Lucafaessler/FingerprintLockProject/docs/presentation/Final Fingerprint Lock with LCD Display.pptx

## Fingerprint Lock with LCD Display Computer Architecture University of Basel, Fall 2024

Luca Fässler, Barththan Sivanantham, Valerio Job

## Project Goal

Ambition
To build a secure access system that uses biometric authentication with a fingerprint sensor, controlled by an Arduino, to ensure a secure lock
- Secure Access: Biometric system using fingerprint recognition to control entry
- Real-Time Feedback: LCD display shows status (e.g., "Access Granted" or "Access Denied")
- Modular Design: Easily adaptable for various access control applications

University of Basel

## Project Goal

Ambition
To build a secure access system that uses biometric authentication with a fingerprint sensor, controlled by an Arduino, to ensure a secure lock
- Secure Access: Biometric system using fingerprint recognition to control entry
- Real-Time Feedback: LCD display shows status (e.g., "Access Granted" or "Access Denied")
- Time-Based Access: Feature to restrict or allow access based on specific time intervals, enhancing security and operational flexibility
- Modular Design: Easily adaptable for various access control applications

## System Overview

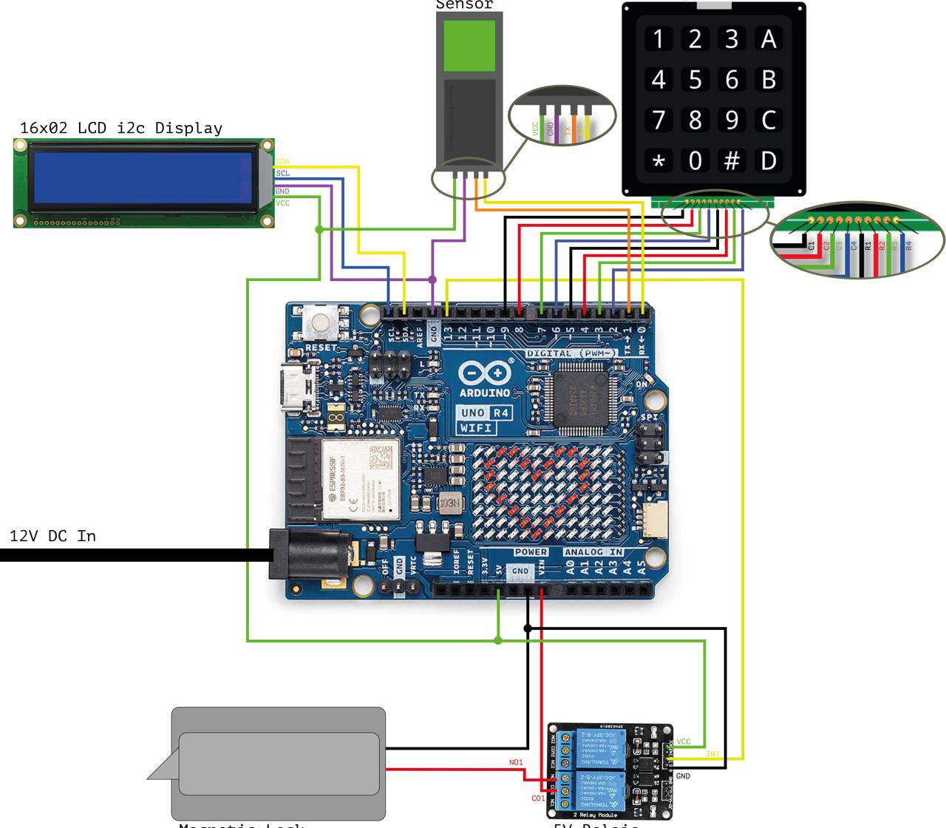
[picture p4: figure]

Circuit Diagram

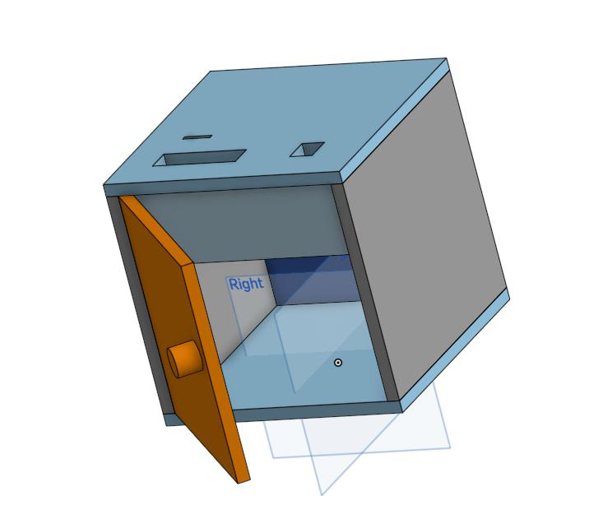
[picture p5: figure]

CAD Visualization

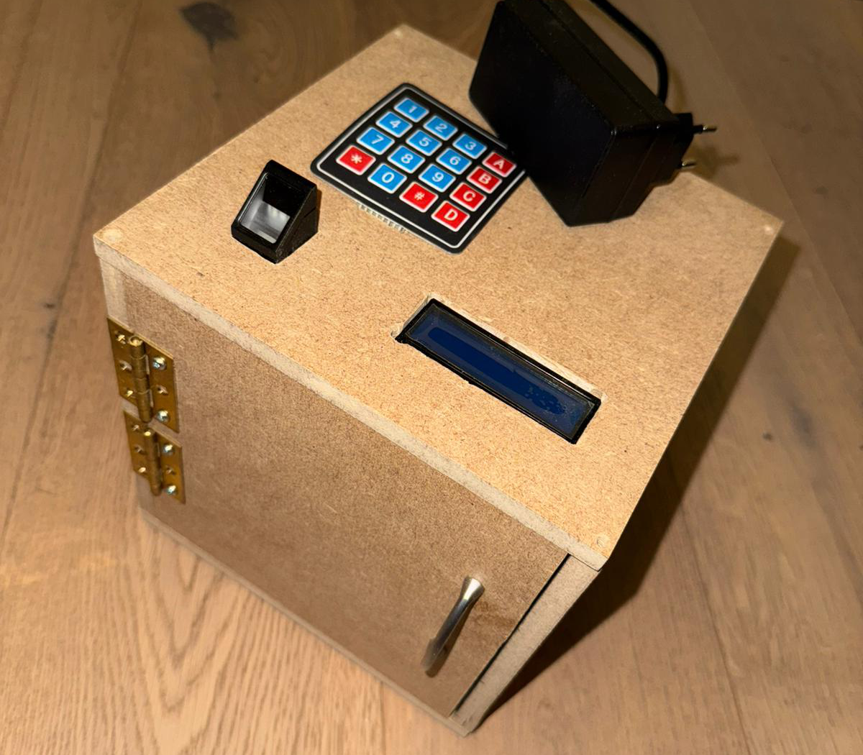
[picture p6: figure]

Final Result

## Hardware Implementation

Hardware
- Arduino UNO R4 Minima/WIFI
- R307 Fingerprint Reader
- 16x2 I2C LCD Display
- 12V DC Electromagnetic Lock
- 2-Channel Relay Module
- 12V DC Power Supply
- Jumper Wires & Breadboard
- RTC SD3031
- Keypad 4x4 Matrix
- Wood, Hinge, Door Handle
Total HW Costs: 236.66 CHF (initially Planned: 106 CHF)

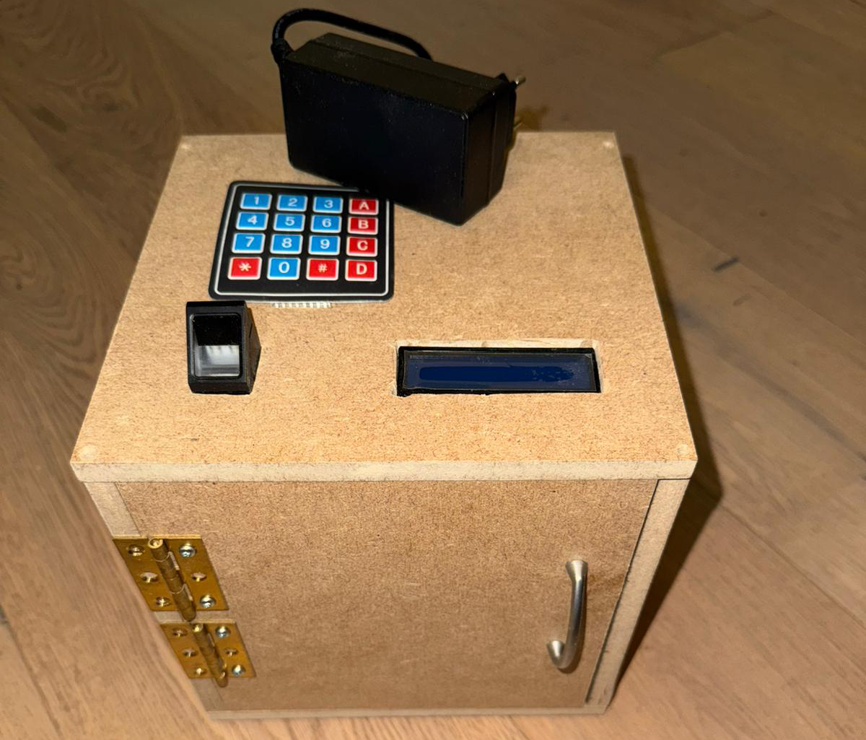
[picture p7: figure]
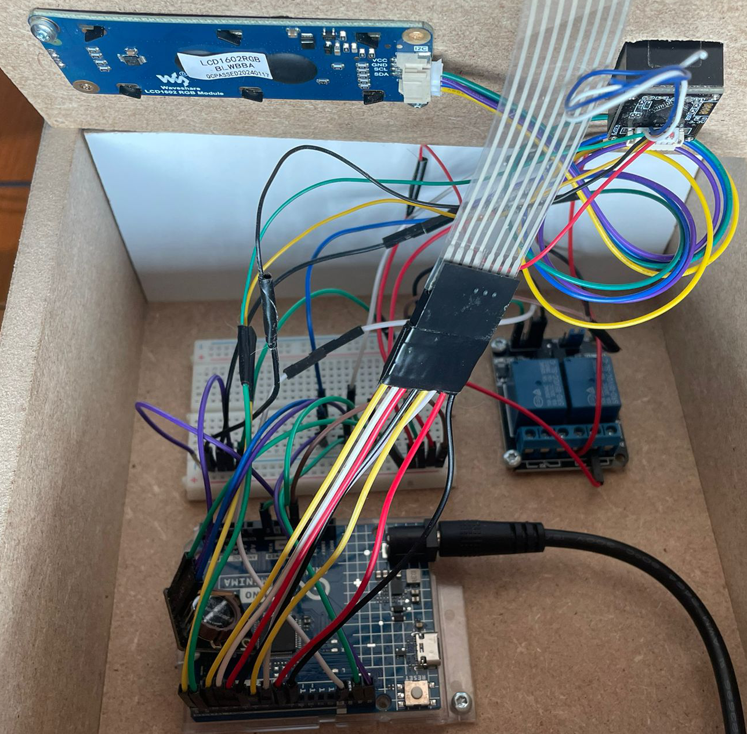
[picture p8: figure]

## Hardware Implementation

Hardware
- Arduino UNO R4 Minima/WIFI
- R307 Fingerprint Reader
- 16x2 I2C LCD Display
- 12V DC Electromagnetic Lock
- 2-Channel Relay Module
- 12V DC Power Supply
- Jumper Wires & Breadboard
- RTC SD3031
- Keypad 4x4 Matrix
- Wood, Hinge, Door Handle
Total HW Costs: 236.66 CHF (initially Planned: 106 CHF)

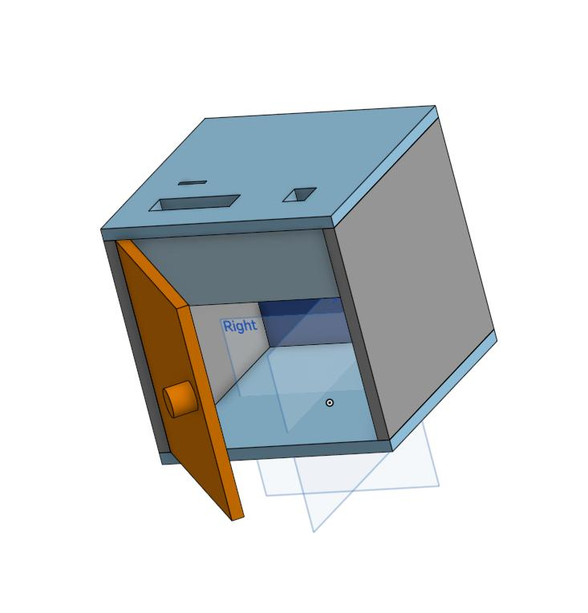
[picture p9: figure]
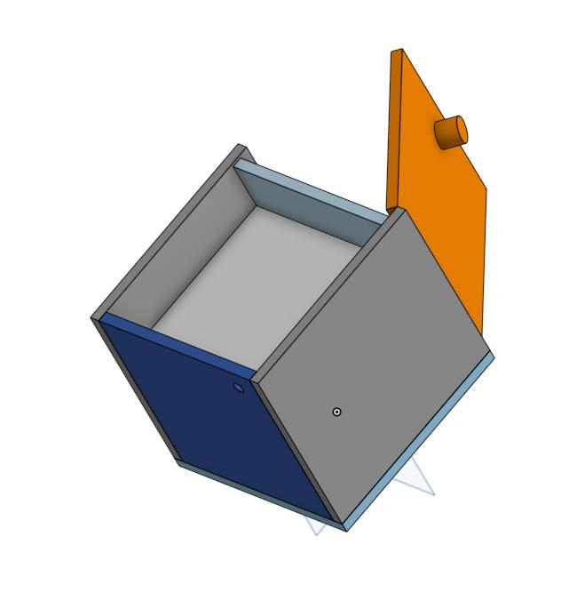
[picture p10: figure]
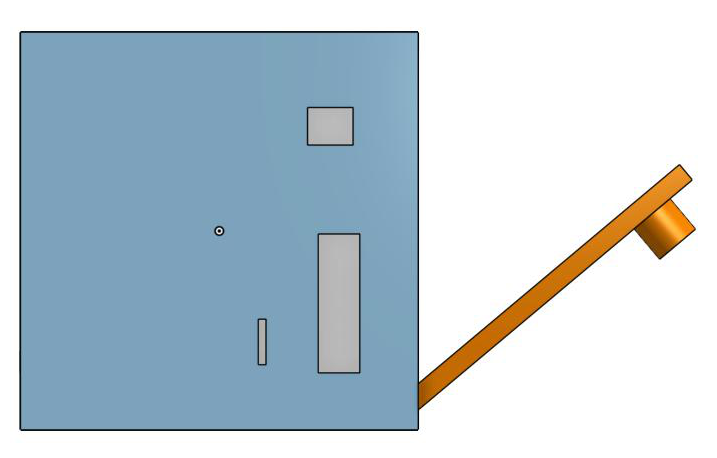
[picture p11: figure]

## Software Implementation

Programming Environment
- Developed using Arduino IDE (C++)
- Serial communication for debugging
Core Functionalities
- Fingerprint Enrollment and Verification
- Time-Based Access Control
  - Access to predefined time slots
- LCD Display Handling
  - User Feedback Messages
- Relay Control
  - Lock Activation upon Verification and Time

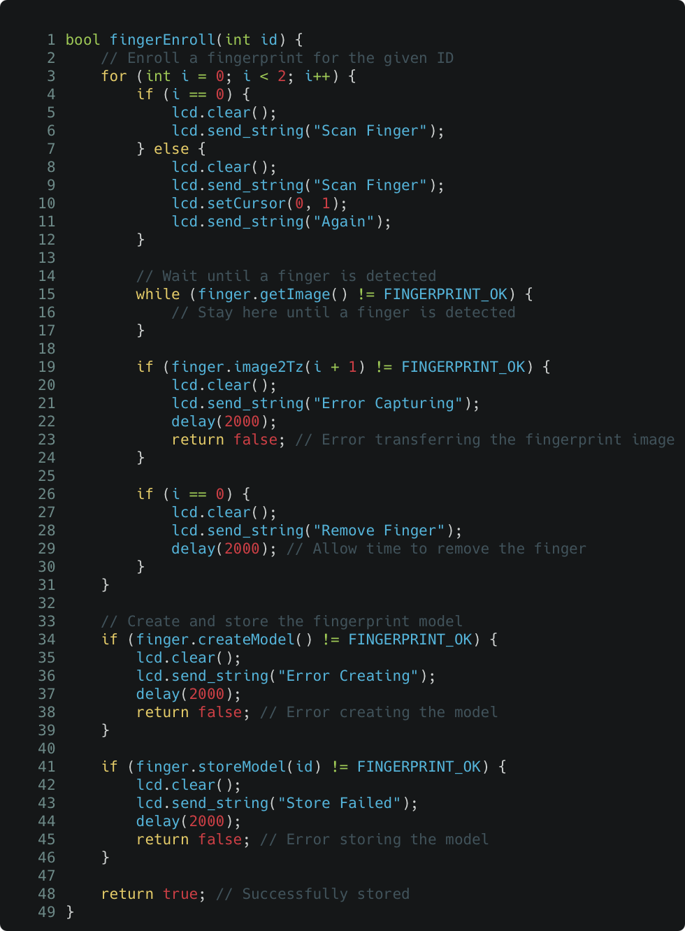
[picture p12: figure]

## Software Implementation

Programming Environment
- Developed using Arduino IDE (C++)
- Serial communication for debugging
Core Functionalities
- Fingerprint Enrollment and Verification
- Time-Based Access Control
  - Access to predefined time slots
- LCD Display Handling
  - User Feedback Messages
- Relay Control
  - Lock Activation upon Verification and Time

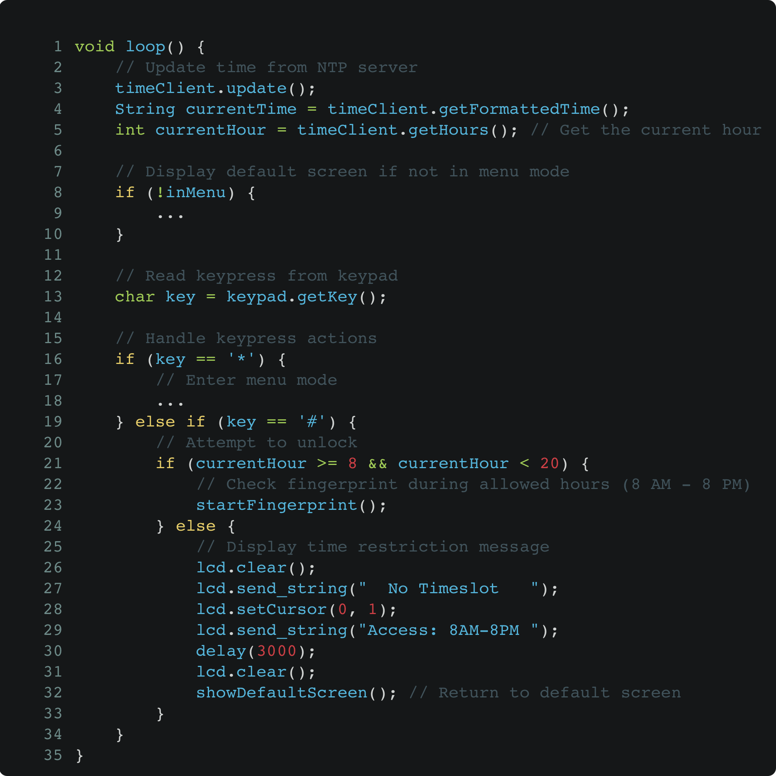
[picture p13: figure]
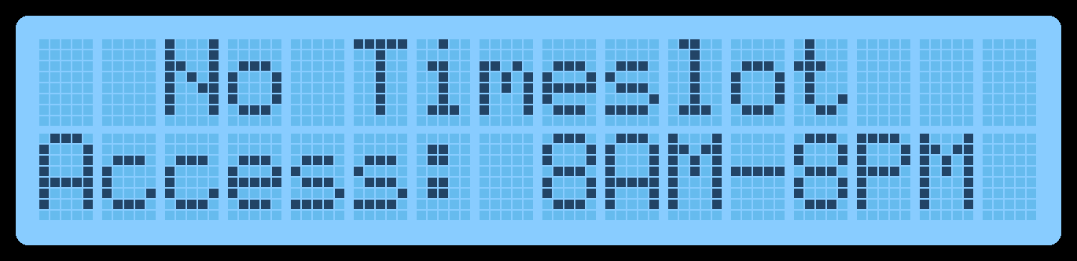
[picture p14: figure]

## Challenges Faced

1. Keypad Sensitivity Issues
Problem: Keypad produced ghost inputs and was overly sensitive
1. RTC Module Challenges
Problem: Difficulties in getting the RTC Module to function correctly
1. Power Supply Issues
Problem: Wrong power supply caused multiple failures; components stopped working, Arduino board was not recognized by the computer
1. LCD Backlight Failure
Problem: LCD backlight stopped functioning at full potential

1. Solution: Switched to a more stable keypad library, which resolved the issue and improved input accuracy
2. Solution: same as 3.
3. Solution: Purchased a new Arduino board with a Wi-Fi module, allowing us to fetch time from the network instead of relying on the RTC module
4. Solution: Replaced the LCD screen with a new one, which resolved the problem

## Demo

## Demo

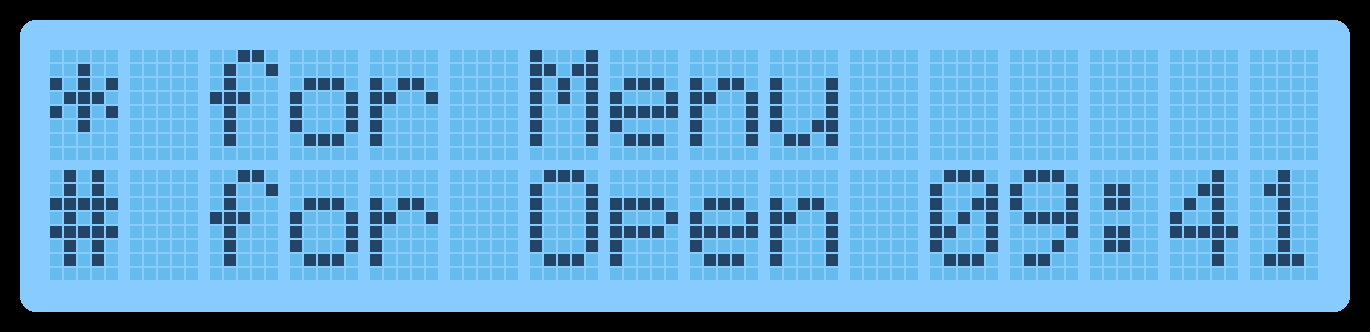
[picture p15: figure]

## Demo

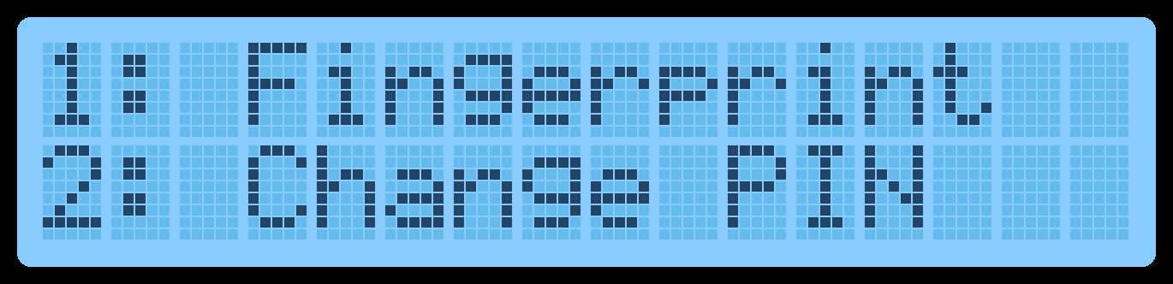
[picture p16: figure]
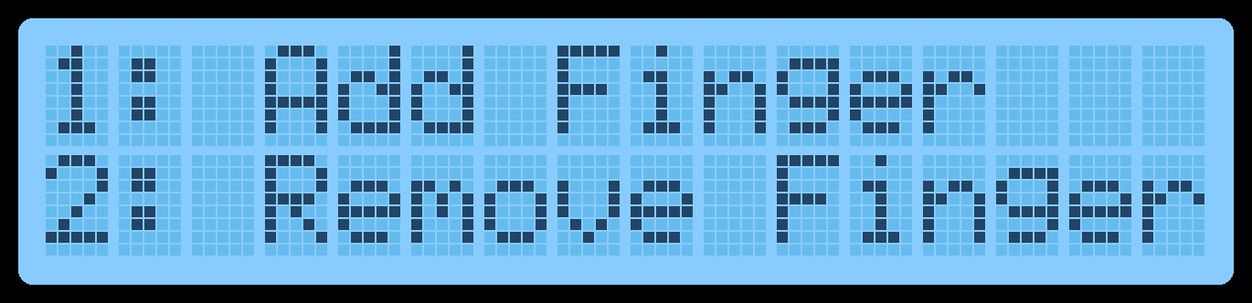
[picture p17: figure]

## Demo

## Demo

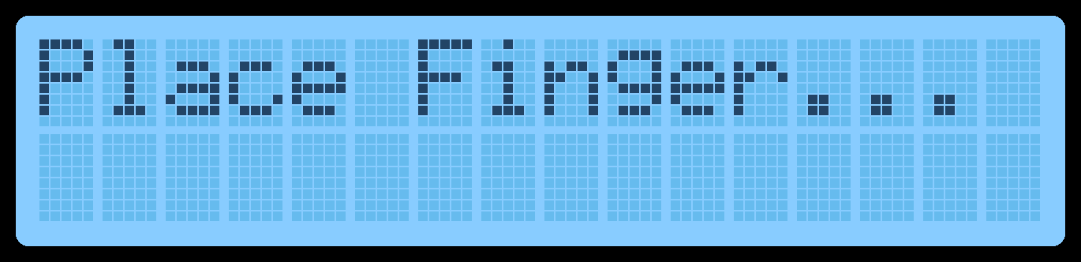
[picture p18: figure]

## Demo

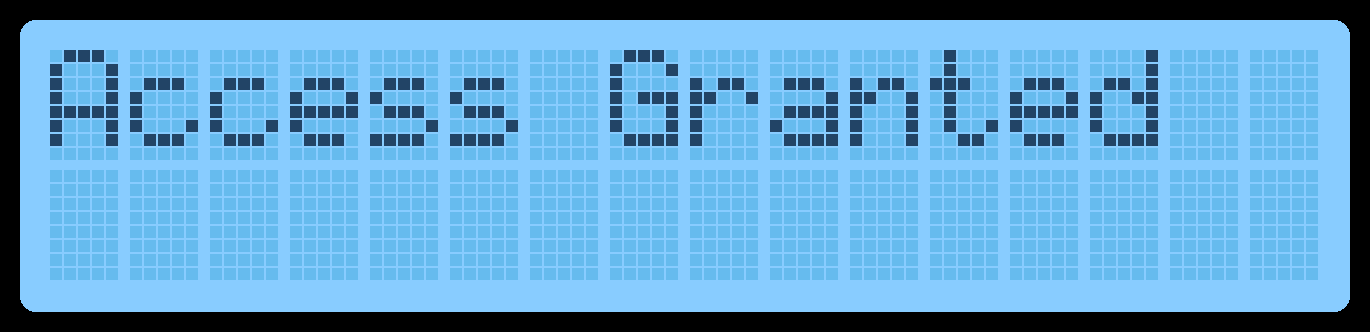
[picture p19: figure]
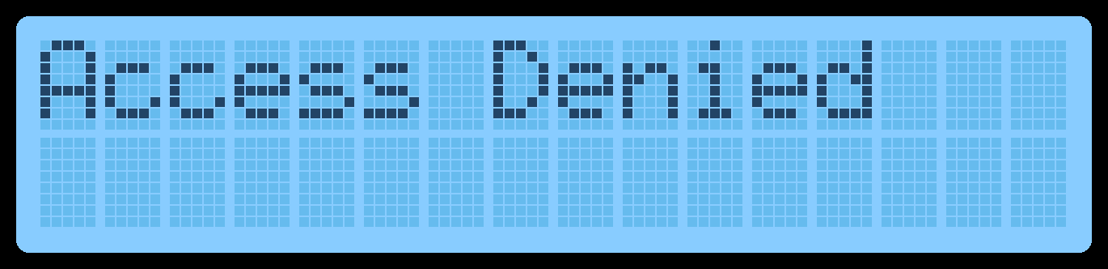
[picture p20: figure]

## Q & A

## Thank you!
