Lucafaessler/FingerprintLockProject/docs/report/images/BOX-2.jpeg

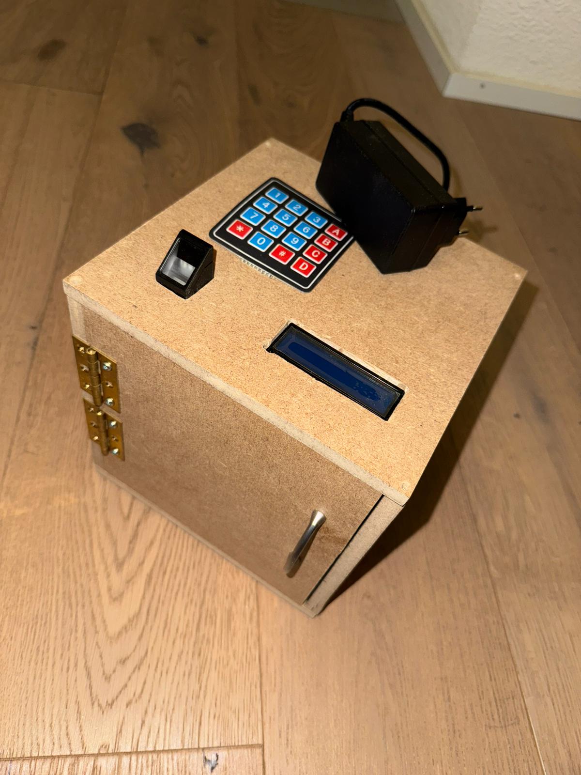
docs/report/images/BOX-2.jpeg
