Lucafaessler/FingerprintLockProject/docs/report/images/BOX-3.jpeg

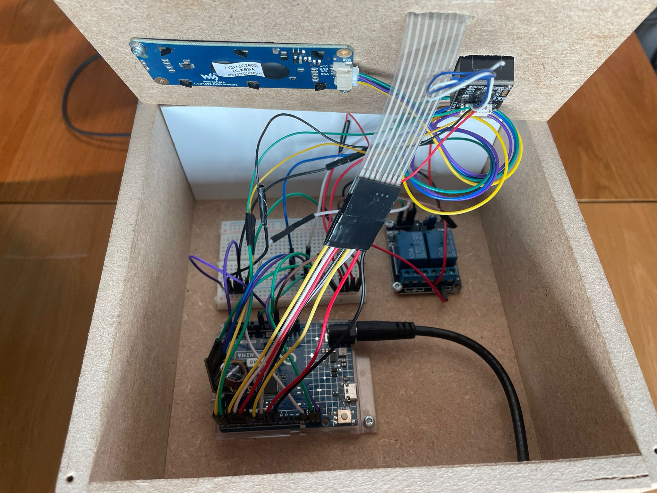
docs/report/images/BOX-3.jpeg
