Lucafaessler/FingerprintLockProject/docs/report/images/BOX-4.jpeg

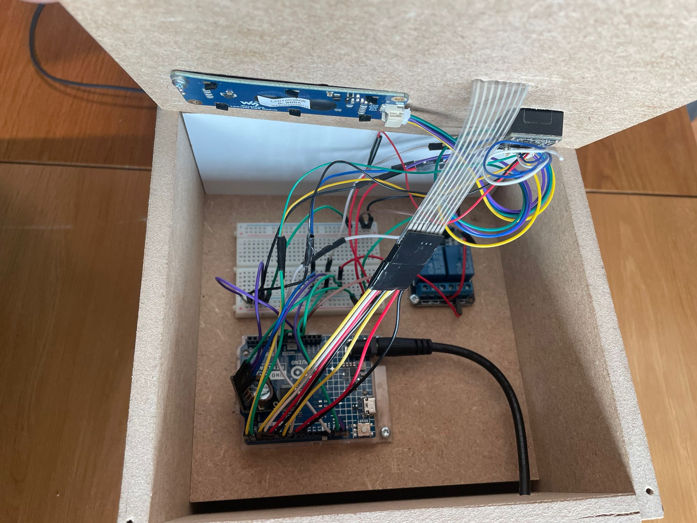
docs/report/images/BOX-4.jpeg
