Lucafaessler/FingerprintLockProject/docs/report/images/BOX.jpeg

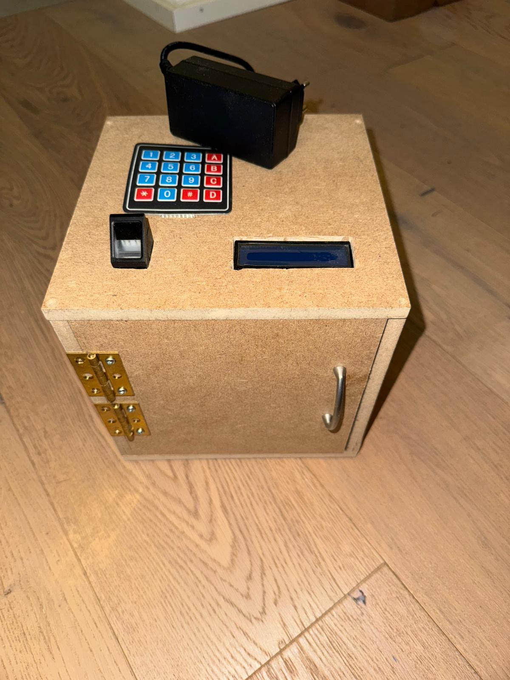
docs/report/images/BOX.jpeg
