Lucafaessler/FingerprintLockProject/docs/report/images/CAD-3.jpeg

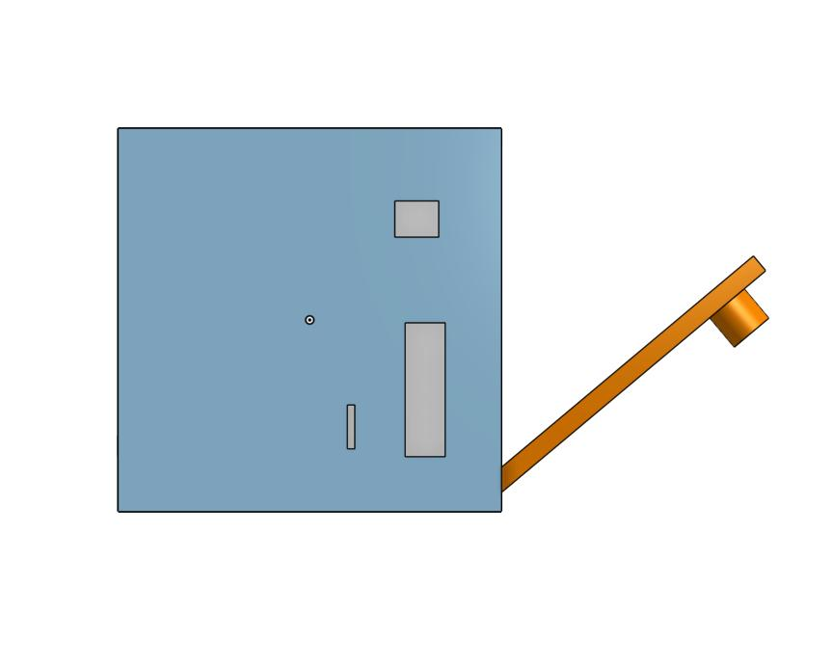
docs/report/images/CAD-3.jpeg
