Lucafaessler/FingerprintLockProject/docs/report/images/CAD-4.jpeg

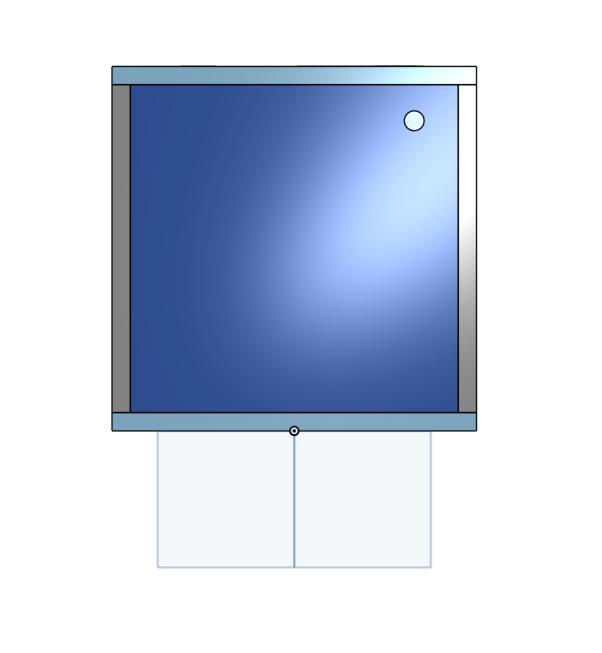
docs/report/images/CAD-4.jpeg
