Lucafaessler/FingerprintLockProject/docs/report/images/FINAL-CIRCUIT.jpeg

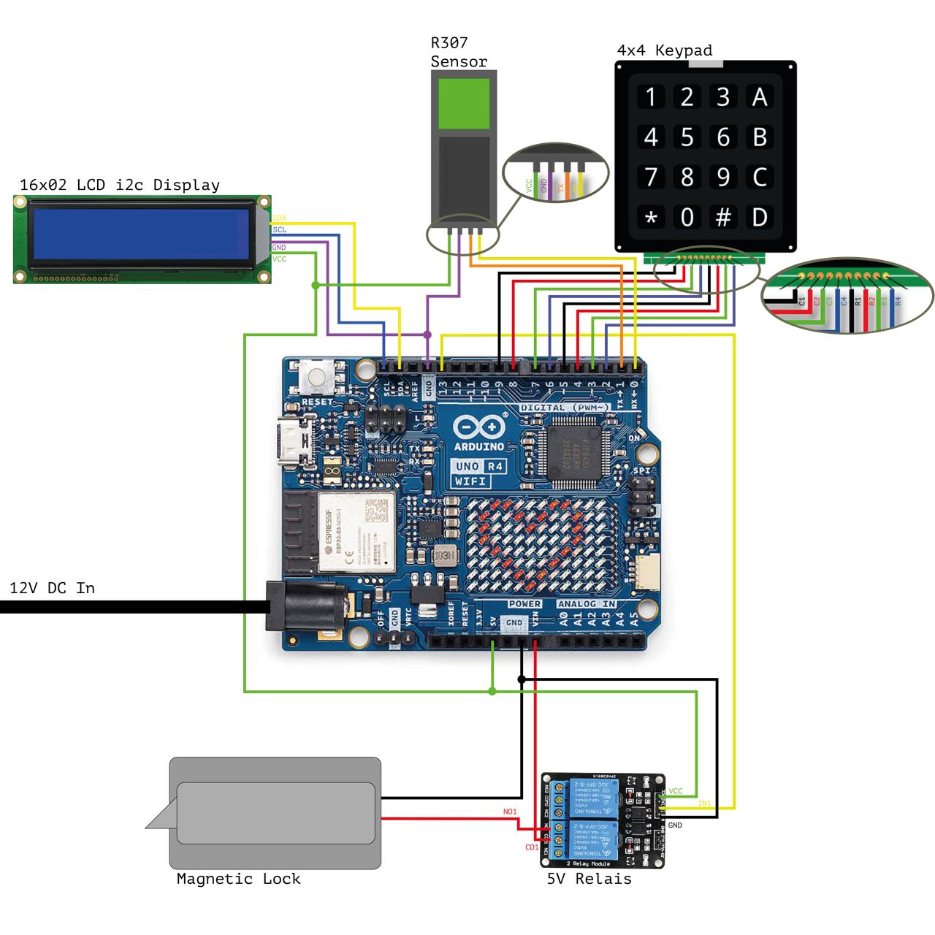
docs/report/images/FINAL-CIRCUIT.jpeg
