Lucafaessler/FingerprintLockProject/docs/report/images/testpicture6.png

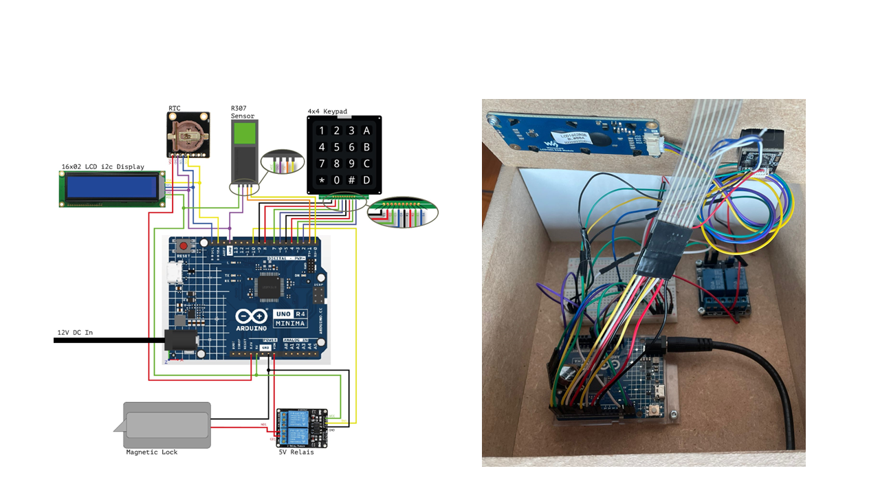
docs/report/images/testpicture6.png
