Lucafaessler/FingerprintLockProject/docs/report/images/testpicture7.png

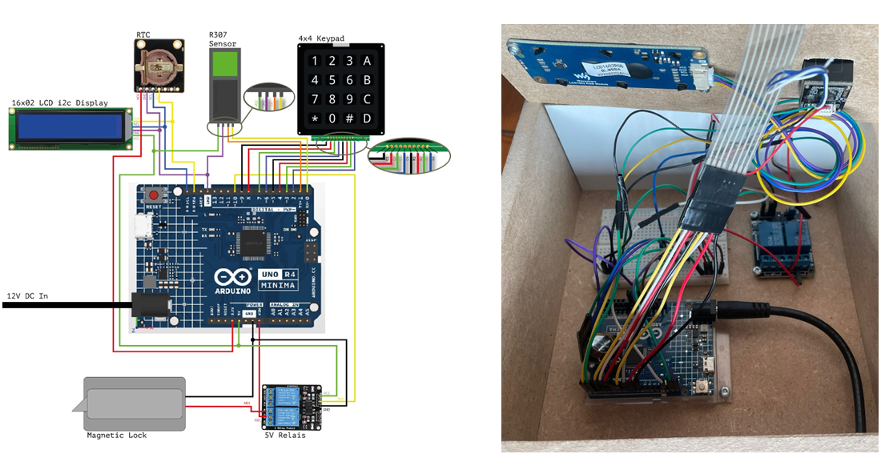
docs/report/images/testpicture7.png
