Lucafaessler/FingerprintLockProject/(commit log)

2025-01-17 automatic ID accquisition and Bugs
    [FingerprintLockProject.cpp, FingerprintLockProject.ino]
2025-01-20 Bug fixes in fingerprint removal
    [FingerprintLockProject.cpp, FingerprintLockProject.ino]
